orihikarna/Mozza62/MozzaBottom/Edge_Cuts-dist.png

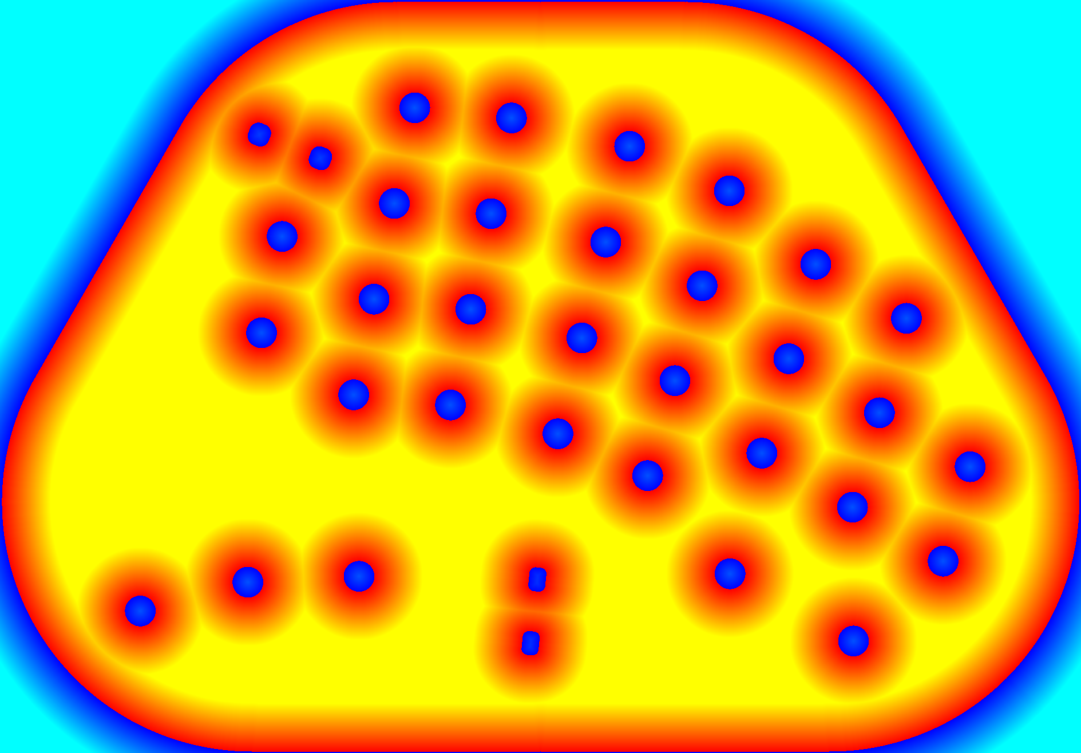
MozzaBottom/Edge_Cuts-dist.png
