orihikarna/Mozza62/layout/kbd-layout.png

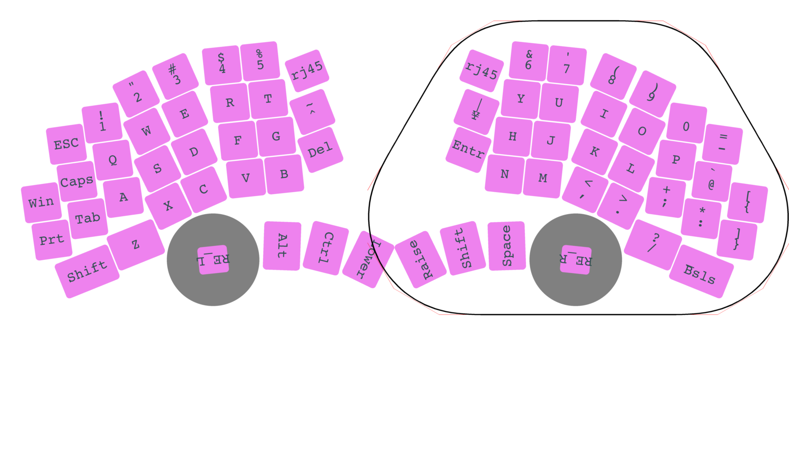
layout/kbd-layout.png
