orihikarna/Mozza62/MozzaBottom/Edge_Cuts-svg.png

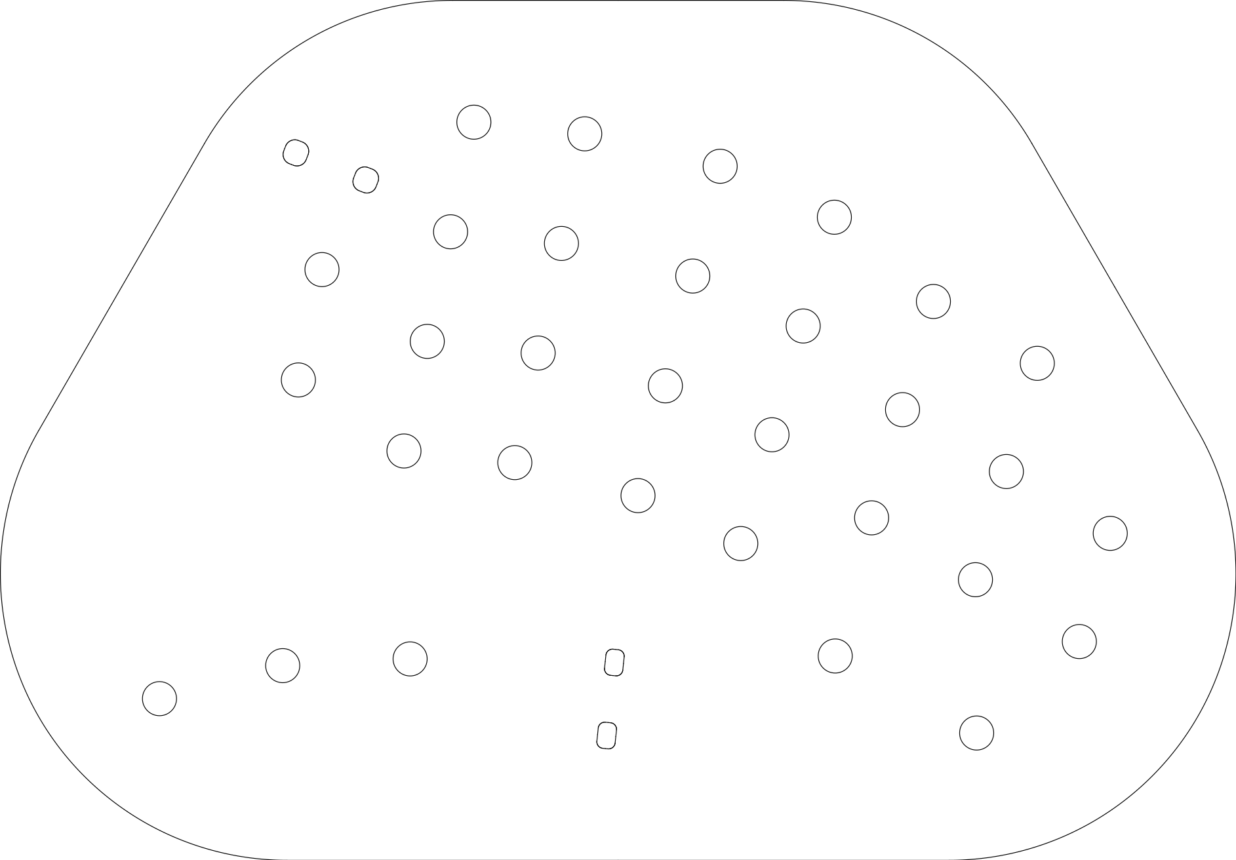
MozzaBottom/Edge_Cuts-svg.png
