orihikarna/Mozza62/layout/kbd-layout.scad

key_w = 17.0;
key_h = 17.0;
key_pos_angles = [
    [49.871, -9.102, -268.000, 22.000, 17.000, 0, "Space"],
    [-49.871, -9.102, 268.000, 22.000, 17.000, 1, "Alt"],
    [30.440, -10.126, -256.000, 22.000, 17.000, 2, "Shift"],
    [-30.440, -10.126, 256.000, 22.000, 17.000, 3, "Ctrl"],
    [11.647, -15.167, -244.000, 22.000, 17.000, 4, "Raise"],
    [-11.647, -15.167, 244.000, 22.000, 17.000, 5, "Lower"],
    [48.932, 22.620, -6.000, 17.000, 17.000, 6, "N"],
    [52.486, 39.340, -6.000, 17.000, 17.000, 7, "H"],
    [56.040, 56.060, -6.000, 17.000, 17.000, 8, "Y"],
    [59.594, 72.780, -6.000, 17.000, 17.000, 9, "&6"],
    [-48.932, 22.620, 6.000, 17.000, 17.000, 10, "B"],
    [-52.486, 39.340, 6.000, 17.000, 17.000, 11, "G"],
    [-56.040, 56.060, 6.000, 17.000, 17.000, 12, "T"],
    [-59.594, 72.780, 6.000, 17.000, 17.000, 13, "%5"],
    [65.839, 20.843, -6.000, 17.000, 17.000, 14, "M"],
    [69.393, 37.563, -6.000, 17.000, 17.000, 15, "J"],
    [72.947, 54.283, -6.000, 17.000, 17.000, 16, "U"],
    [76.501, 71.003, -6.000, 17.000, 17.000, 17, "'7"],
    [-65.839, 20.843, 6.000, 17.000, 17.000, 18, "V"],
    [-69.393, 37.563, 6.000, 17.000, 17.000, 19, "F"],
    [-72.947, 54.283, 6.000, 17.000, 17.000, 20, "R"],
    [-76.501, 71.003, 6.000, 17.000, 17.000, 21, "$4"],
    [84.626, 15.809, -24.000, 17.000, 17.000, 22, "<,"],
    [88.802, 32.558, -24.000, 17.000, 17.000, 23, "K"],
    [92.978, 49.308, -24.000, 17.000, 17.000, 24, "I"],
    [97.155, 66.057, -24.000, 17.000, 17.000, 25, "(8"],
    [-84.626, 15.809, 24.000, 17.000, 17.000, 26, "C"],
    [-88.802, 32.558, 24.000, 17.000, 17.000, 27, "D"],
    [-92.978, 49.308, 24.000, 17.000, 17.000, 28, "E"],
    [-97.155, 66.057, 24.000, 17.000, 17.000, 29, "#3"],
    [100.300, 8.500, -26.000, 17.000, 17.000, 30, ">."],
    [105.058, 25.094, -26.000, 17.000, 17.000, 31, "L"],
    [109.816, 41.687, -26.000, 17.000, 17.000, 32, "O"],
    [114.574, 58.281, -26.000, 17.000, 17.000, 33, ")9"],
    [-100.300, 8.500, 26.000, 17.000, 17.000, 34, "X"],
    [-105.058, 25.094, 26.000, 17.000, 17.000, 35, "S"],
    [-109.816, 41.687, 26.000, 17.000, 17.000, 36, "W"],
    [-114.574, 58.281, 26.000, 17.000, 17.000, 37, "\"2"],
    [120.250, 12.419, -8.000, 17.000, 17.000, 38, "+;"],
    [124.965, 28.924, -8.000, 17.000, 17.000, 39, "P"],
    [129.680, 45.428, -8.000, 17.000, 17.000, 40, " 0"],
    [-120.250, 12.419, 8.000, 17.000, 17.000, 41, "A"],
    [-124.965, 28.924, 8.000, 17.000, 17.000, 42, "Q"],
    [-129.680, 45.428, 8.000, 17.000, 17.000, 43, "!1"],
    [136.091, 2.983, -8.000, 17.000, 17.000, 44, "*:"],
    [140.806, 19.487, -8.000, 17.000, 17.000, 45, "`@"],
    [145.520, 35.992, -8.000, 17.000, 17.000, 46, "=-"],
    [-136.091, 2.983, 8.000, 17.000, 17.000, 47, "Tab"],
    [-140.806, 19.487, 8.000, 17.000, 17.000, 48, "Caps"],
    [-145.520, 35.992, 8.000, 17.000, 17.000, 49, "ESC"],
    [151.932, -6.454, -8.000, 17.000, 17.000, 50, "]}"],
    [156.647, 10.051, -8.000, 17.000, 17.000, 51, "[{"],
    [-151.932, -6.454, 8.000, 17.000, 17.000, 52, "Prt"],
    [-156.647, 10.051, 8.000, 17.000, 17.000, 53, "Win"],
    [114.702, -8.656, -22.000, 22.800, 17.000, 54, "?/"],
    [-114.702, -8.656, 22.000, 22.800, 17.000, 55, "Z"],
    [136.271, -20.407, -22.000, 26.000, 17.000, 56, "_Bsls"],
    [-136.271, -20.407, 22.000, 26.000, 17.000, 57, "Shift"],
    [32.828, 33.456, -21.234, 17.000, 17.000, 58, "Entr"],
    [36.429, 50.295, -21.234, 17.000, 17.000, 59, "|¥"],
    [-32.828, 33.456, 21.234, 17.000, 17.000, 60, "Del"],
    [-36.429, 50.295, 21.234, 17.000, 17.000, 61, "~^"],
    [38.752, 68.542, -21.234, 16.910, 15.480, 62, "rj45"],
    [-38.752, 68.542, 21.234, 16.910, 15.480, 63, "rj45"],
    [80.434, -15.221, -186.000, 13.700, 12.700, 64, "RE_R"],
    [-80.434, -15.221, 186.000, 13.700, 12.700, 65, "RE_L"],
];
