orihikarna/Mozza62/MozzaTop/MozzaTop-Edge_Cuts.pdf

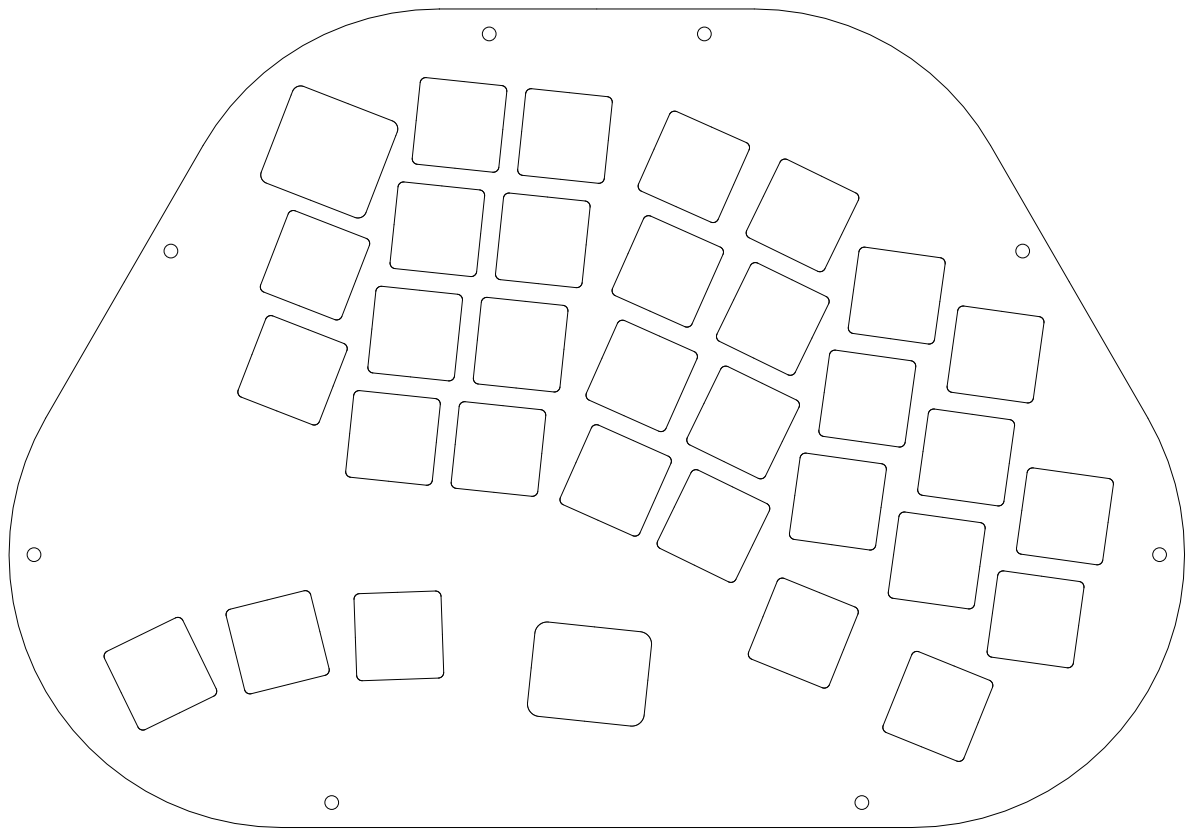
[picture p4: page 1]
