orihikarna/Mozza62/Mozzarella/Mozzarella.kicad_pcb

## KiCad design Mozzarella/Mozzarella.kicad_pcb (2024-10-05)

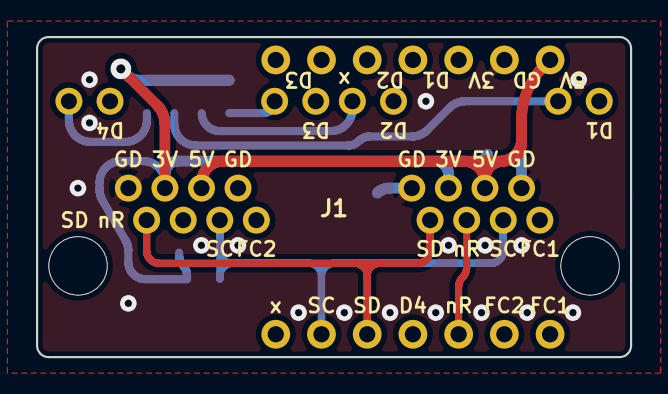
[picture p5: board Mozzarella.kicad_pcb from above]

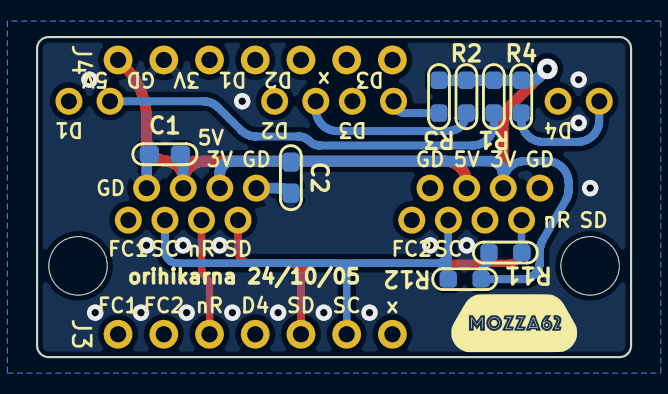
[picture p6: board Mozzarella.kicad_pcb from below]

Board: 4 copper layers, 33.0 x 17.8 mm, 12 parts (11 on the bottom side), 16 nets.

Parts:
C1, C2: 0.1u; C_1608_HandSolder
G1: LOGO; mozza62_logo2
J1: RJ45_LED_Shielded_x2; RJ45_Amphenol_RJHSE508X-02
J3, J4: Conn_01x07; PinHeader_1x07_P2.54mm_Vertical
R1, R2, R3, R4: 1k; R_1608_HandSolder
R11, R12: 2.2k; R_1608_HandSolder

Connections:
3V3: C2.1, J1.6, J1.18, J4.3, R1.1, R2.1, R3.1, R4.1, R11.2, R12.2
5VD: C1.1, J1.4, J1.16, J4.1
GND: C1.2, C2.2, J1.2, J1.8, J1.14, J1.20, J4.2
LED1: J1.9, J4.4
LED2: J1.11, J4.5
LED3: J1.21, J4.7
LED4: J1.23, J3.4
NRST: J1.5, J1.17, J3.3
unnamed: J1.10, R1.2
unnamed: J1.12, R2.2
unnamed: J1.22, R3.2
unnamed: J1.24, R4.2
RGB1: J1.1, J3.1
RGB2: J1.13, J3.2
SCK: J1.3, J1.15, J3.6, R12.1
SDA: J1.7, J1.19, J3.5, R11.1
