orihikarna/Mozza62/MozzaCircuit/MozzaCircuit.kicad_pcb

## KiCad design MozzaCircuit/MozzaCircuit.kicad_pcb (2023-05-06)

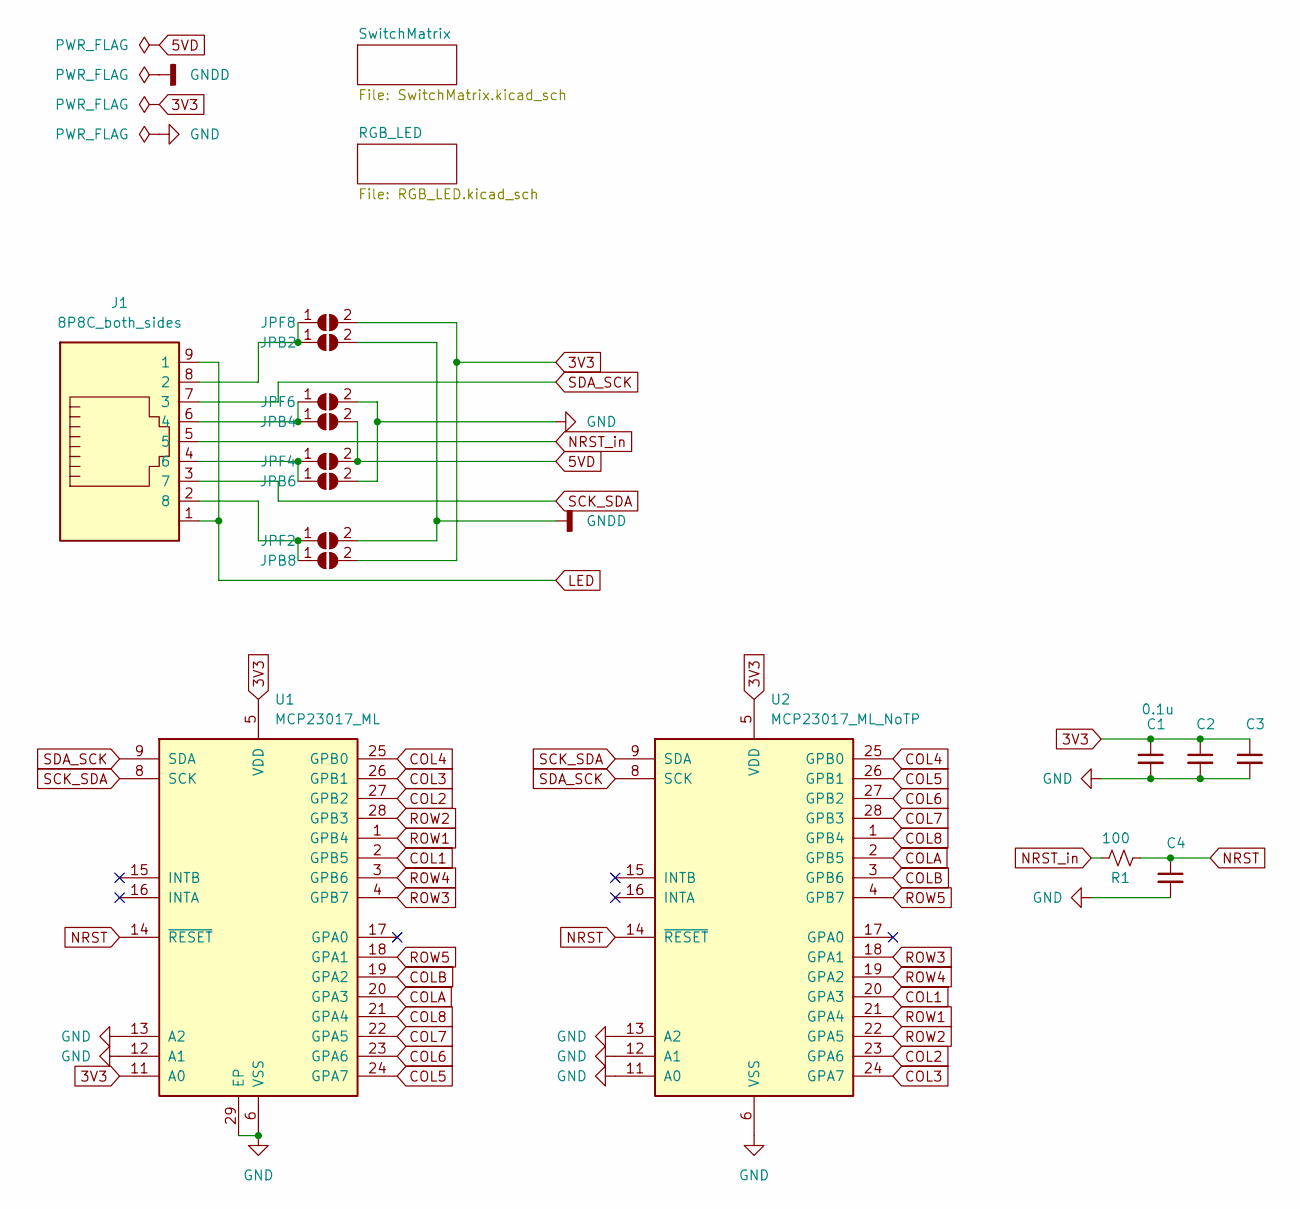
[picture p7: schematic MozzaCircuit.kicad_sch]

Parts:
C1: 0.1u; C_1608_HandSolder
C2: C_Small; C_1608_HandSolder
C3, C4: C_Small; C_1608_HandSolder_both_sides
J1: 8P8C_both_sides; RJ45_Molex_0955032884_both_sides
JPB2, JPB4, JPB6, JPB8: SolderJumper_2_Open; SolderJumper-2_P1.3mm_Open_TrianglePad1.0x1.5mm
JPF2, JPF4, JPF6, JPF8: SolderJumper_2_Open; SolderJumper-2_P1.3mm_Open_TrianglePad1.0x1.5mm
R1: 100; R_1608_HandSolder_both_sides
U1: MCP23017_ML; QFN-28-1EP_6x6mm_P0.65mm_EP4.25x4.25mm_Hand
U2: MCP23017_ML_NoTP; QFN-28-1EP_6x6mm_P0.65mm_EP4.25x4.25mm_Hand_NoTP

Connections:
3V3: C1.1, C2.1, C3.1, JPB8.2 (B), JPF8.2 (B), U1.5 (VDD), U1.11 (A0), U2.5 (VDD); also elsewhere on the board
5VD: JPB4.2 (B), JPF4.2 (B); also elsewhere on the board
COL1: U1.2 (GPB5), U2.20 (GPA3); also elsewhere on the board
COL2: U1.27 (GPB2), U2.23 (GPA6); also elsewhere on the board
COL3: U1.26 (GPB1), U2.24 (GPA7); also elsewhere on the board
COL4: U1.25 (GPB0), U2.25 (GPB0); also elsewhere on the board
COL5: U1.24 (GPA7), U2.26 (GPB1); also elsewhere on the board
COL6: U1.23 (GPA6), U2.27 (GPB2); also elsewhere on the board
COL7: U1.22 (GPA5), U2.28 (GPB3); also elsewhere on the board
COL8: U1.21 (GPA4), U2.1 (GPB4); also elsewhere on the board
COLA: U1.20 (GPA3), U2.2 (GPB5); also elsewhere on the board
COLB: U1.19 (GPA2), U2.3 (GPB6); also elsewhere on the board
GND: C1.2, C2.2, C3.2, C4.2, JPB6.2 (B), JPF6.2 (B), U1.6 (VSS), U1.12 (A1), U1.13 (A2), U1.29 (EP), U2.6 (VSS), U2.11 (A0), U2.12 (A1), U2.13 (A2); also elsewhere on the board
GNDD: JPB2.2 (B), JPF2.2 (B); also elsewhere on the board
LED: J1.1, J1.9 (1); also elsewhere on the board
NRST: C4.1, R1.2, U1.14 (~RESET), U2.14 (~RESET)
NRST_in: J1.5, R1.1
unnamed: J1.2 (8), JPB8.1 (A), JPF2.1 (A)
unnamed: J1.4 (6), JPB6.1 (A), JPF4.1 (A)
unnamed: J1.6 (4), JPB4.1 (A), JPF6.1 (A)
unnamed: J1.8 (2), JPB2.1 (A), JPF8.1 (A)
ROW1: U1.1 (GPB4), U2.21 (GPA4); also elsewhere on the board
ROW2: U1.28 (GPB3), U2.22 (GPA5); also elsewhere on the board
ROW3: U1.4 (GPB7), U2.18 (GPA1); also elsewhere on the board
ROW4: U1.3 (GPB6), U2.19 (GPA2); also elsewhere on the board
ROW5: U1.18 (GPA1), U2.4 (GPB7); also elsewhere on the board
SCK_SDA: J1.3 (7), U1.8 (SCK), U2.9 (SDA)
SDA_SCK: J1.7 (3), U1.9 (SDA), U2.8 (SCK)

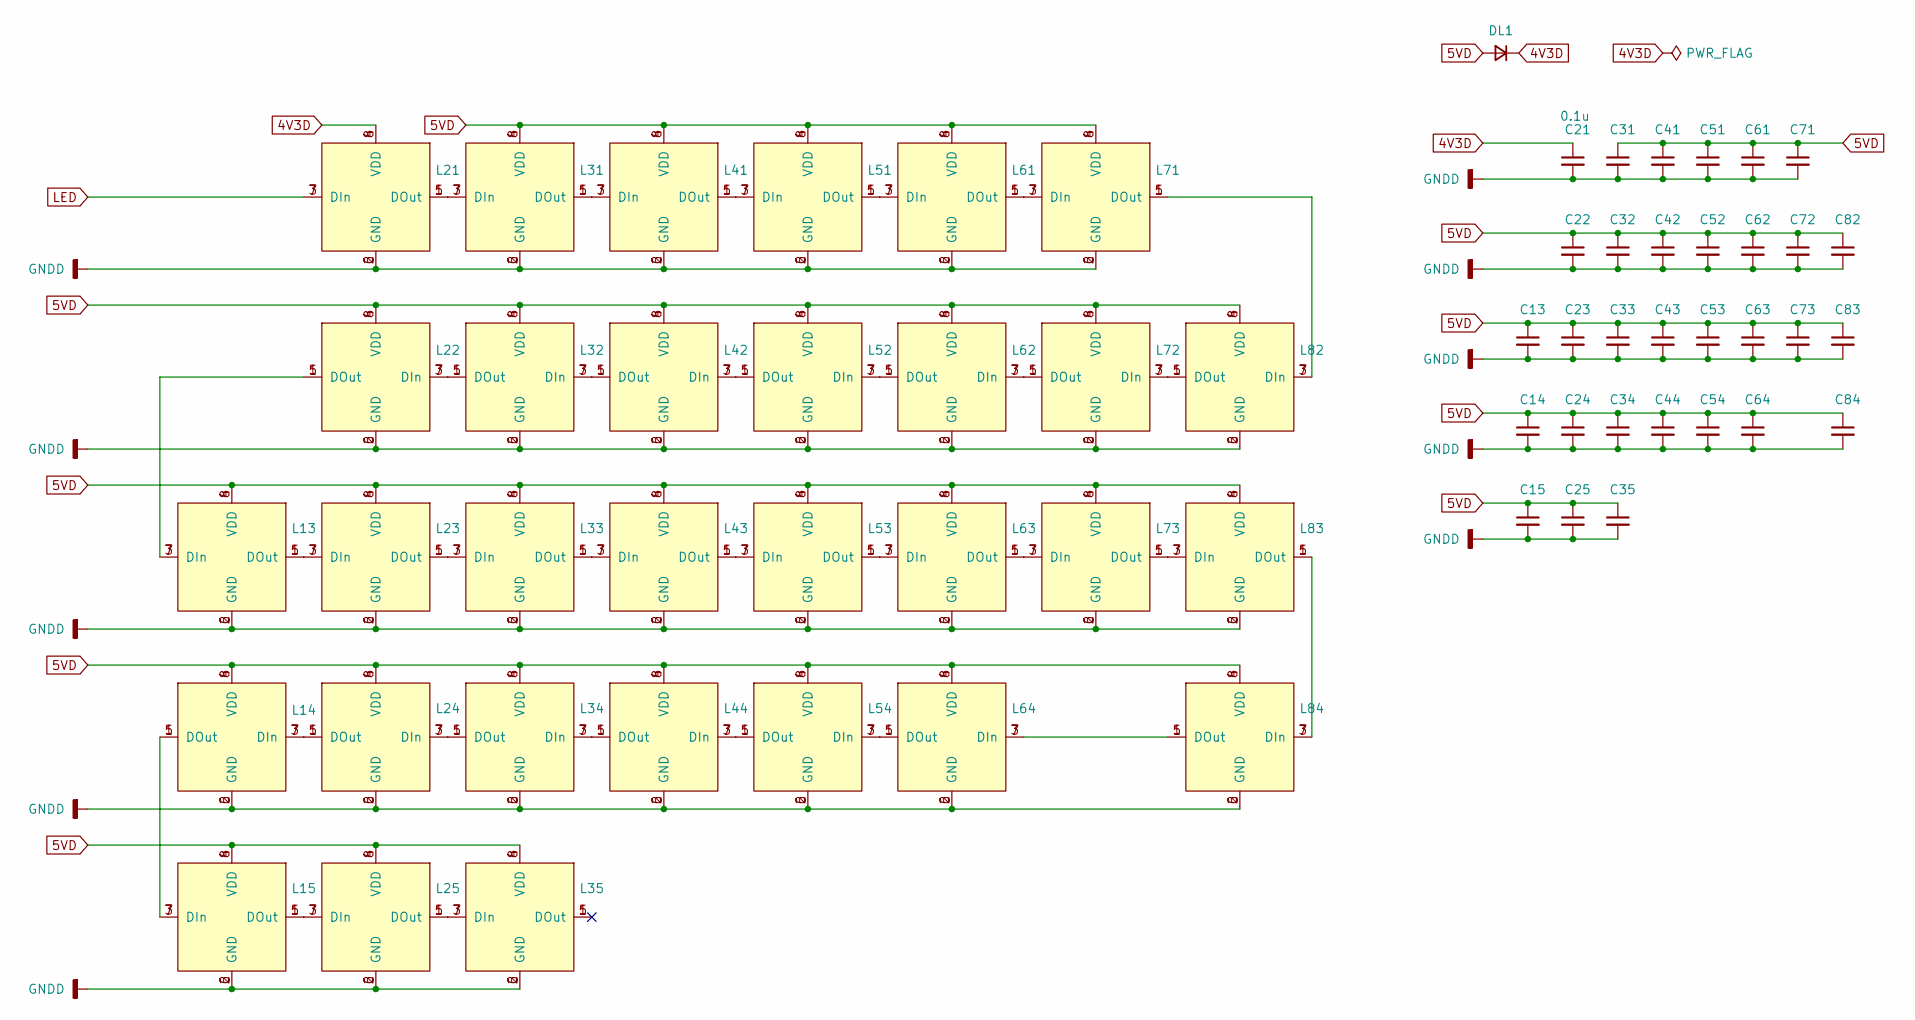
[picture p8: schematic RGB_LED.kicad_sch]

Parts:
C13, C14, C15, C22, C23, C24, C25, C31, C32, C33, C34, C35, C41, C42, C43, C44, C51, C52, C53, C54, C61, C62, C63, C64, C71, C72, C73, C82, C83, C84: C_Small; C_1608_HandSolder_both_sides
C21: 0.1u; C_1608_HandSolder_both_sides
DL1: D_Small; D_SOD-323_both_sides
L13, L14, L15, L21, L22, L23, L24, L25, L31, L32, L33, L34, L35, L41, L42, L43, L44, L51, L52, L53, L54, L61, L62, L63, L64, L71, L72, L73, L82, L83, L84: WS2812-2020_both_sides; WS2812B_2020_rev

Connections:
4V3D: C21.1, DL1.1 (K), L21.4 (VDD), L21.8; also elsewhere on the board
5VD: C13.1, C14.1, C15.1, C22.1, C23.1, C24.1, C25.1, C31.1, C32.1, C33.1, C34.1, C35.1, C41.1, C42.1, C43.1, C44.1, C51.1, C52.1, C53.1, C54.1, C61.1, C62.1, C63.1, C64.1, C71.1, C72.1, C73.1, C82.1, C83.1, C84.1, DL1.2 (A), L13.4 (VDD), L13.8, L14.4 (VDD), L14.8, L15.4 (VDD), L15.8, L22.4 (VDD), L22.8, L23.4 (VDD), L23.8, L24.4 (VDD), L24.8, L25.4 (VDD), L25.8, L31.4 (VDD), L31.8, L32.4 (VDD), L32.8, L33.4 (VDD), L33.8, L34.4 (VDD), L34.8, L35.4 (VDD), L35.8, L41.4 (VDD), L41.8, L42.4 (VDD), L42.8, L43.4 (VDD), L43.8, L44.4 (VDD), L44.8, L51.4 (VDD), L51.8, L52.4 (VDD), L52.8, L53.4 (VDD), L53.8, L54.4 (VDD), L54.8, L61.4 (VDD), L61.8, L62.4 (VDD), L62.8, L63.4 (VDD), L63.8, L64.4 (VDD), L64.8, L71.4 (VDD), L71.8, L72.4 (VDD), L72.8, L73.4 (VDD), L73.8, L82.4 (VDD), L82.8, L83.4 (VDD), L83.8, L84.4 (VDD), L84.8; also elsewhere on the board
GNDD: C13.2, C14.2, C15.2, C21.2, C22.2, C23.2, C24.2, C25.2, C31.2, C32.2, C33.2, C34.2, C35.2, C41.2, C42.2, C43.2, C44.2, C51.2, C52.2, C53.2, C54.2, C61.2, C62.2, C63.2, C64.2, C71.2, C72.2, C73.2, C82.2, C83.2, C84.2, L13.2 (GND), L13.6, L14.2 (GND), L14.6, L15.2 (GND), L15.6, L21.2 (GND), L21.6, L22.2 (GND), L22.6, L23.2 (GND), L23.6, L24.2 (GND), L24.6, L25.2 (GND), L25.6, L31.2 (GND), L31.6, L32.2 (GND), L32.6, L33.2 (GND), L33.6, L34.2 (GND), L34.6, L35.2 (GND), L35.6, L41.2 (GND), L41.6, L42.2 (GND), L42.6, L43.2 (GND), L43.6, L44.2 (GND), L44.6, L51.2 (GND), L51.6, L52.2 (GND), L52.6, L53.2 (GND), L53.6, L54.2 (GND), L54.6, L61.2 (GND), L61.6, L62.2 (GND), L62.6, L63.2 (GND), L63.6, L64.2 (GND), L64.6, L71.2 (GND), L71.6, L72.2 (GND), L72.6, L73.2 (GND), L73.6, L82.2 (GND), L82.6, L83.2 (GND), L83.6, L84.2 (GND), L84.6; also elsewhere on the board
LED: L21.3 (DIn), L21.7 (DIn); also elsewhere on the board
unnamed: L13.1 (DOut), L13.5 (DOut), L23.3 (DIn), L23.7 (DIn)
unnamed: L13.3 (DIn), L13.7 (DIn), L22.1 (DOut), L22.5 (DOut)
unnamed: L14.1 (DOut), L14.5 (DOut), L15.3 (DIn), L15.7 (DIn)
unnamed: L14.3 (DIn), L14.7 (DIn), L24.1 (DOut), L24.5 (DOut)
unnamed: L15.1 (DOut), L15.5 (DOut), L25.3 (DIn), L25.7 (DIn)
unnamed: L21.1 (DOut), L21.5 (DOut), L31.3 (DIn), L31.7 (DIn)
unnamed: L22.3 (DIn), L22.7 (DIn), L32.1 (DOut), L32.5 (DOut)
unnamed: L23.1 (DOut), L23.5 (DOut), L33.3 (DIn), L33.7 (DIn)
unnamed: L24.3 (DIn), L24.7 (DIn), L34.1 (DOut), L34.5 (DOut)
unnamed: L25.1 (DOut), L25.5 (DOut), L35.3 (DIn), L35.7 (DIn)
unnamed: L31.1 (DOut), L31.5 (DOut), L41.3 (DIn), L41.7 (DIn)
unnamed: L32.3 (DIn), L32.7 (DIn), L42.1 (DOut), L42.5 (DOut)
unnamed: L33.1 (DOut), L33.5 (DOut), L43.3 (DIn), L43.7 (DIn)
unnamed: L34.3 (DIn), L34.7 (DIn), L44.1 (DOut), L44.5 (DOut)
unnamed: L41.1 (DOut), L41.5 (DOut), L51.3 (DIn), L51.7 (DIn)
unnamed: L42.3 (DIn), L42.7 (DIn), L52.1 (DOut), L52.5 (DOut)
unnamed: L43.1 (DOut), L43.5 (DOut), L53.3 (DIn), L53.7 (DIn)
unnamed: L44.3 (DIn), L44.7 (DIn), L54.1 (DOut), L54.5 (DOut)
unnamed: L51.1 (DOut), L51.5 (DOut), L61.3 (DIn), L61.7 (DIn)
unnamed: L52.3 (DIn), L52.7 (DIn), L62.1 (DOut), L62.5 (DOut)
unnamed: L53.1 (DOut), L53.5 (DOut), L63.3 (DIn), L63.7 (DIn)
unnamed: L54.3 (DIn), L54.7 (DIn), L64.1 (DOut), L64.5 (DOut)
unnamed: L61.1 (DOut), L61.5 (DOut), L71.3 (DIn), L71.7 (DIn)
unnamed: L62.3 (DIn), L62.7 (DIn), L72.1 (DOut), L72.5 (DOut)
unnamed: L63.1 (DOut), L63.5 (DOut), L73.3 (DIn), L73.7 (DIn)
unnamed: L64.3 (DIn), L64.7 (DIn), L84.1 (DOut), L84.5 (DOut)
unnamed: L71.1 (DOut), L71.5 (DOut), L82.3 (DIn), L82.7 (DIn)
unnamed: L72.3 (DIn), L72.7 (DIn), L82.1 (DOut), L82.5 (DOut)
unnamed: L73.1 (DOut), L73.5 (DOut), L83.3 (DIn), L83.7 (DIn)
unnamed: L83.1 (DOut), L83.5 (DOut), L84.3 (DIn), L84.7 (DIn)

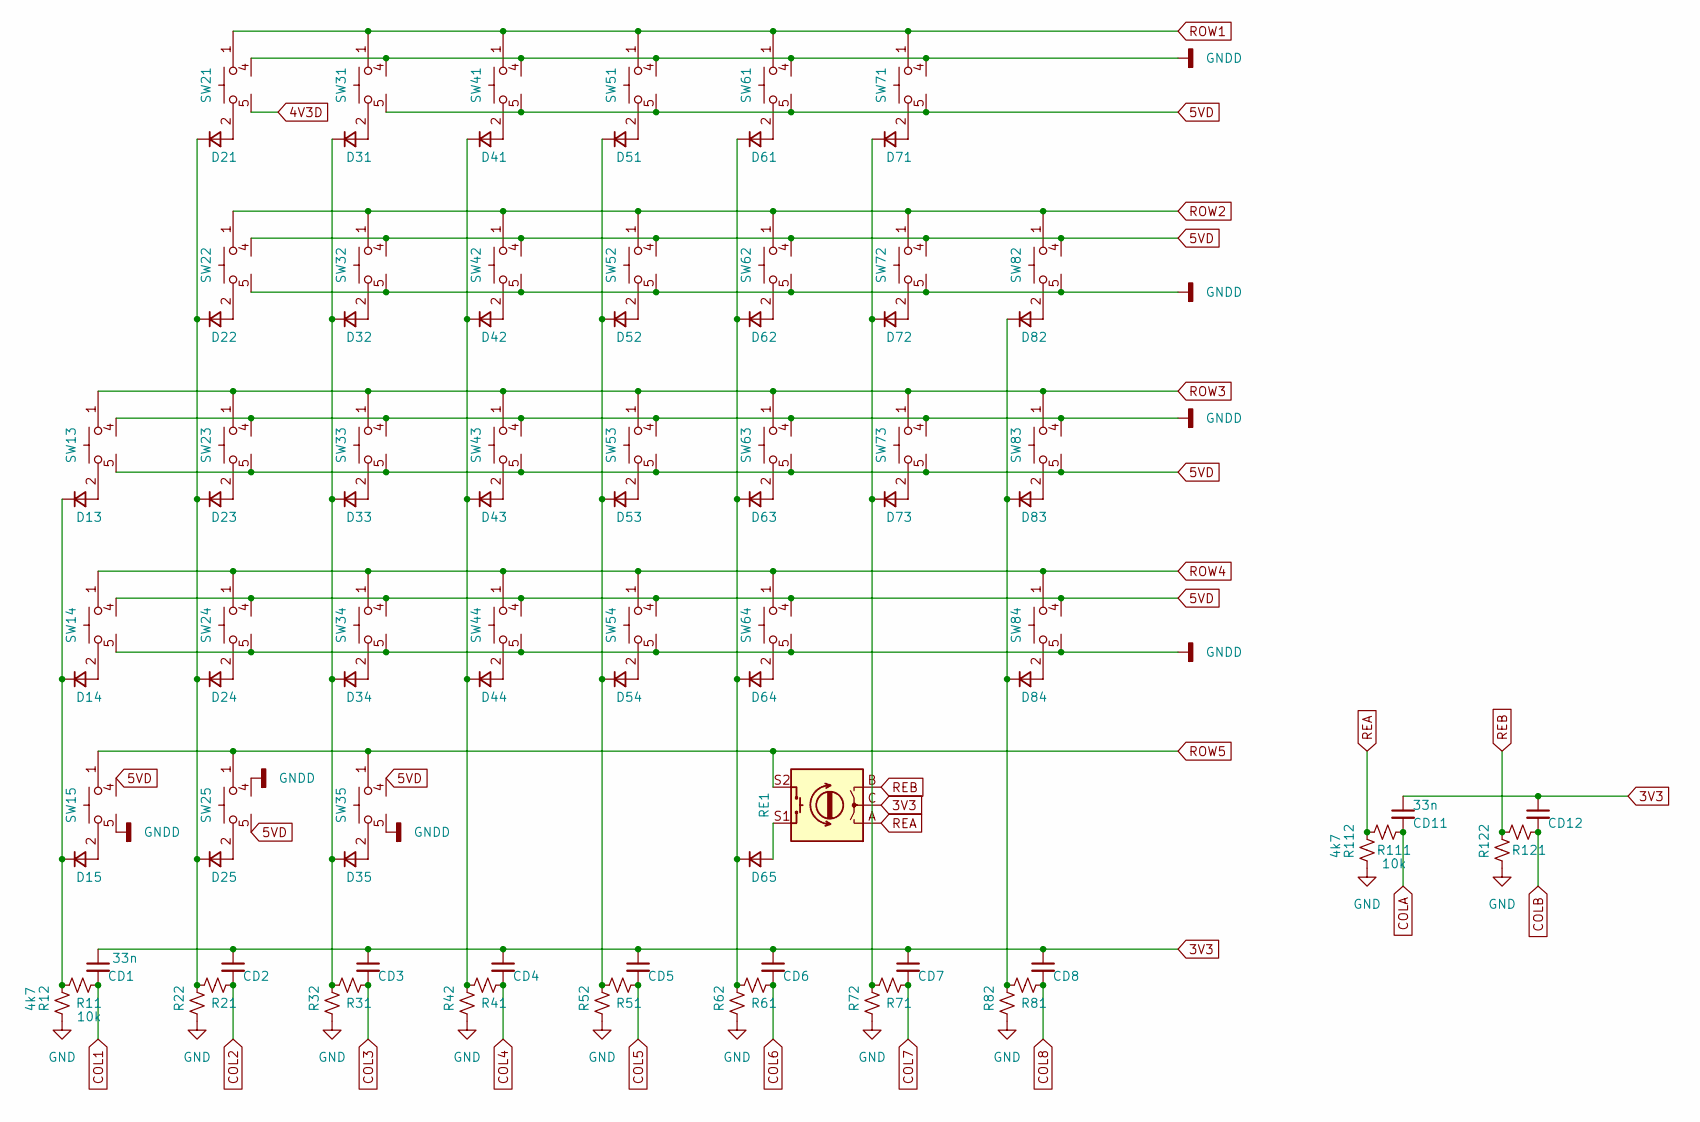
[picture p9: schematic SwitchMatrix.kicad_sch]

Parts:
CD1, CD11: 33n; C_1608_HandSolder_both_sides
CD2, CD3, CD4, CD5, CD6, CD7, CD8, CD12: C_Small; C_1608_HandSolder_both_sides
D13, D14, D15, D21, D22, D23, D24, D25, D31, D32, D33, D34, D35, D41, D42, D43, D44, D51, D52, D53, D54, D61, D62, D63, D64, D65, D71, D72, D73, D82, D83, D84: D_Small; D_SOD-323_both_sides
R11, R111: 10k; R_1608_HandSolder_both_sides
R12, R112: 4k7; R_1608_HandSolder_both_sides
R21, R22, R31, R32, R41, R42, R51, R52, R61, R62, R71, R72, R81, R82, R121, R122: R_Small_US; R_1608_HandSolder_both_sides
RE1: RotaryEncoder_Switch; RotaryEncoder_Bourns_PEC12R-4215F
SW13, SW14, SW15, SW21, SW22, SW23, SW24, SW25, SW31, SW32, SW33, SW34, SW35, SW41, SW42, SW43, SW44, SW51, SW52, SW53, SW54, SW61, SW62, SW63, SW64, SW71, SW72, SW73, SW82, SW83, SW84: SW_ChocV2_rev; ChocV2_rev

Connections:
3V3: CD1.1, CD2.1, CD3.1, CD4.1, CD5.1, CD6.1, CD7.1, CD8.1, CD11.1, CD12.1, RE1.C; also elsewhere on the board
4V3D: SW21.5; also elsewhere on the board
5VD: SW13.5, SW14.4, SW15.4, SW22.4, SW23.5, SW24.4, SW25.5, SW31.5, SW32.4, SW33.5, SW34.4, SW35.4, SW41.5, SW42.4, SW43.5, SW44.4, SW51.5, SW52.4, SW53.5, SW54.4, SW61.5, SW62.4, SW63.5, SW64.4, SW71.5, SW72.4, SW73.5, SW82.4, SW83.5, SW84.4; also elsewhere on the board
COL1: CD1.2, R11.2; also elsewhere on the board
COL2: CD2.2, R21.2; also elsewhere on the board
COL3: CD3.2, R31.2; also elsewhere on the board
COL4: CD4.2, R41.2; also elsewhere on the board
COL5: CD5.2, R51.2; also elsewhere on the board
COL6: CD6.2, R61.2; also elsewhere on the board
COL7: CD7.2, R71.2; also elsewhere on the board
COL8: CD8.2, R81.2; also elsewhere on the board
COLA: CD11.2, R111.2; also elsewhere on the board
COLB: CD12.2, R121.2; also elsewhere on the board
GND: R12.2, R22.2, R32.2, R42.2, R52.2, R62.2, R72.2, R82.2, R112.2, R122.2; also elsewhere on the board
GNDD: SW13.4, SW14.5, SW15.5, SW21.4, SW22.5, SW23.4, SW24.5, SW25.4, SW31.4, SW32.5, SW33.4, SW34.5, SW35.5, SW41.4, SW42.5, SW43.4, SW44.5, SW51.4, SW52.5, SW53.4, SW54.5, SW61.4, SW62.5, SW63.4, SW64.5, SW71.4, SW72.5, SW73.4, SW82.5, SW83.4, SW84.5; also elsewhere on the board
unnamed: D13.1 (K), D14.1 (K), D15.1 (K), R11.1, R12.1
unnamed: D13.2 (A), SW13.2, SW13.3
unnamed: D14.2 (A), SW14.2, SW14.3
unnamed: D15.2 (A), SW15.2, SW15.3
unnamed: D21.1 (K), D22.1 (K), D23.1 (K), D24.1 (K), D25.1 (K), R21.1, R22.1
unnamed: D21.2 (A), SW21.2, SW21.3
unnamed: D22.2 (A), SW22.2, SW22.3
unnamed: D23.2 (A), SW23.2, SW23.3
unnamed: D24.2 (A), SW24.2, SW24.3
unnamed: D25.2 (A), SW25.2, SW25.3
unnamed: D31.1 (K), D32.1 (K), D33.1 (K), D34.1 (K), D35.1 (K), R31.1, R32.1
unnamed: D31.2 (A), SW31.2, SW31.3
unnamed: D32.2 (A), SW32.2, SW32.3
unnamed: D33.2 (A), SW33.2, SW33.3
unnamed: D34.2 (A), SW34.2, SW34.3
unnamed: D35.2 (A), SW35.2, SW35.3
unnamed: D41.1 (K), D42.1 (K), D43.1 (K), D44.1 (K), R41.1, R42.1
unnamed: D41.2 (A), SW41.2, SW41.3
unnamed: D42.2 (A), SW42.2, SW42.3
unnamed: D43.2 (A), SW43.2, SW43.3
unnamed: D44.2 (A), SW44.2, SW44.3
unnamed: D51.1 (K), D52.1 (K), D53.1 (K), D54.1 (K), R51.1, R52.1
unnamed: D51.2 (A), SW51.2, SW51.3
unnamed: D52.2 (A), SW52.2, SW52.3
unnamed: D53.2 (A), SW53.2, SW53.3
unnamed: D54.2 (A), SW54.2, SW54.3
unnamed: D61.1 (K), D62.1 (K), D63.1 (K), D64.1 (K), D65.1 (K), R61.1, R62.1
unnamed: D61.2 (A), SW61.2, SW61.3
unnamed: D62.2 (A), SW62.2, SW62.3
unnamed: D63.2 (A), SW63.2, SW63.3
unnamed: D64.2 (A), SW64.2, SW64.3
unnamed: D65.2 (A), RE1.S1
unnamed: D71.1 (K), D72.1 (K), D73.1 (K), R71.1, R72.1
unnamed: D71.2 (A), SW71.2, SW71.3
unnamed: D72.2 (A), SW72.2, SW72.3
unnamed: D73.2 (A), SW73.2, SW73.3
unnamed: D82.1 (K), D83.1 (K), D84.1 (K), R81.1, R82.1
unnamed: D82.2 (A), SW82.2, SW82.3
unnamed: D83.2 (A), SW83.2, SW83.3
unnamed: D84.2 (A), SW84.2, SW84.3
REA: R111.1, R112.1, RE1.A
REB: R121.1, R122.1, RE1.B
ROW1: SW21.1, SW31.1, SW41.1, SW51.1, SW61.1, SW71.1; also elsewhere on the board
ROW2: SW22.1, SW32.1, SW42.1, SW52.1, SW62.1, SW72.1, SW82.1; also elsewhere on the board
ROW3: SW13.1, SW23.1, SW33.1, SW43.1, SW53.1, SW63.1, SW73.1, SW83.1; also elsewhere on the board
ROW4: SW14.1, SW24.1, SW34.1, SW44.1, SW54.1, SW64.1, SW84.1; also elsewhere on the board
ROW5: RE1.S2, SW15.1, SW25.1, SW35.1; also elsewhere on the board

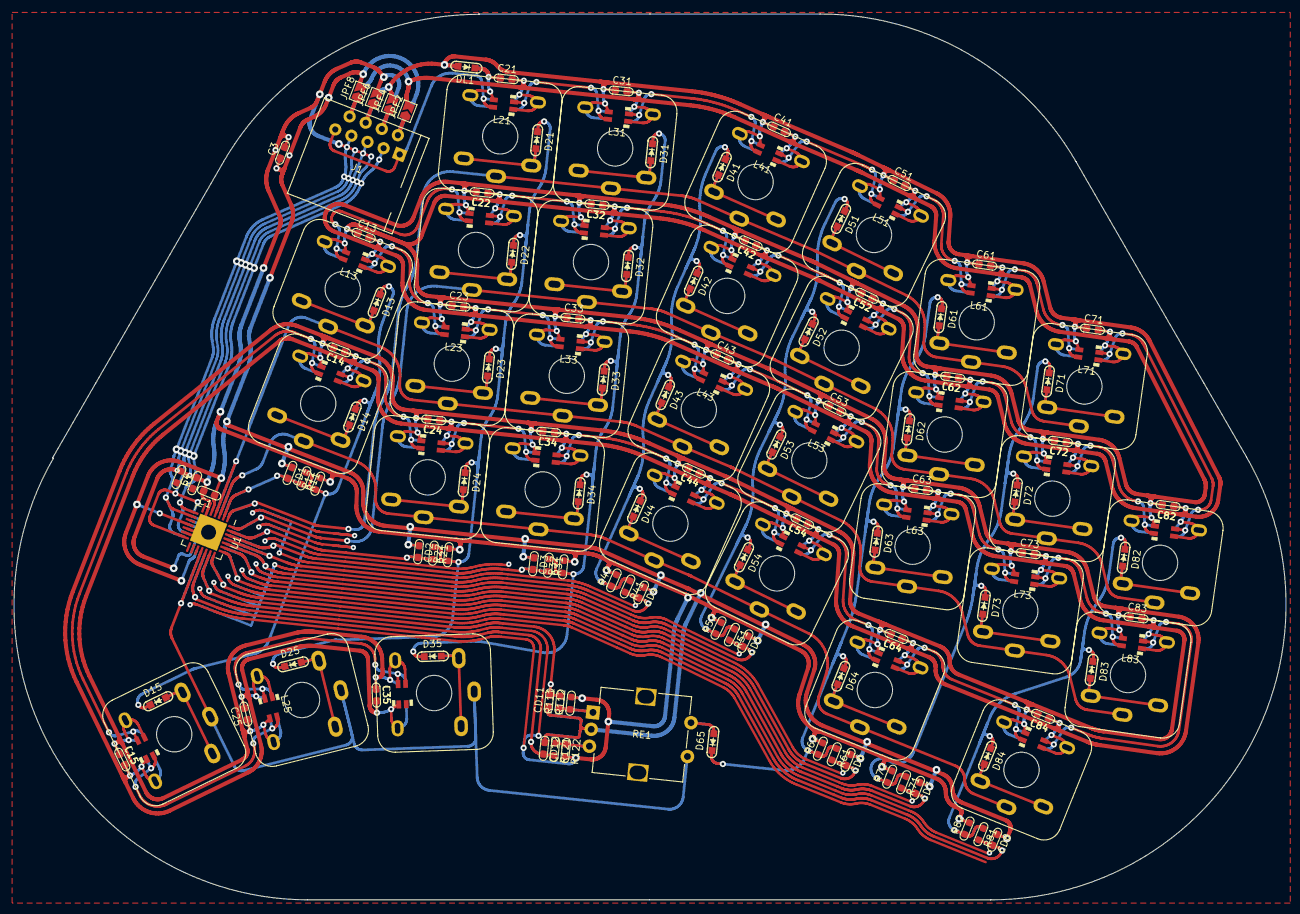
[picture p10: board MozzaCircuit.kicad_pcb from above]

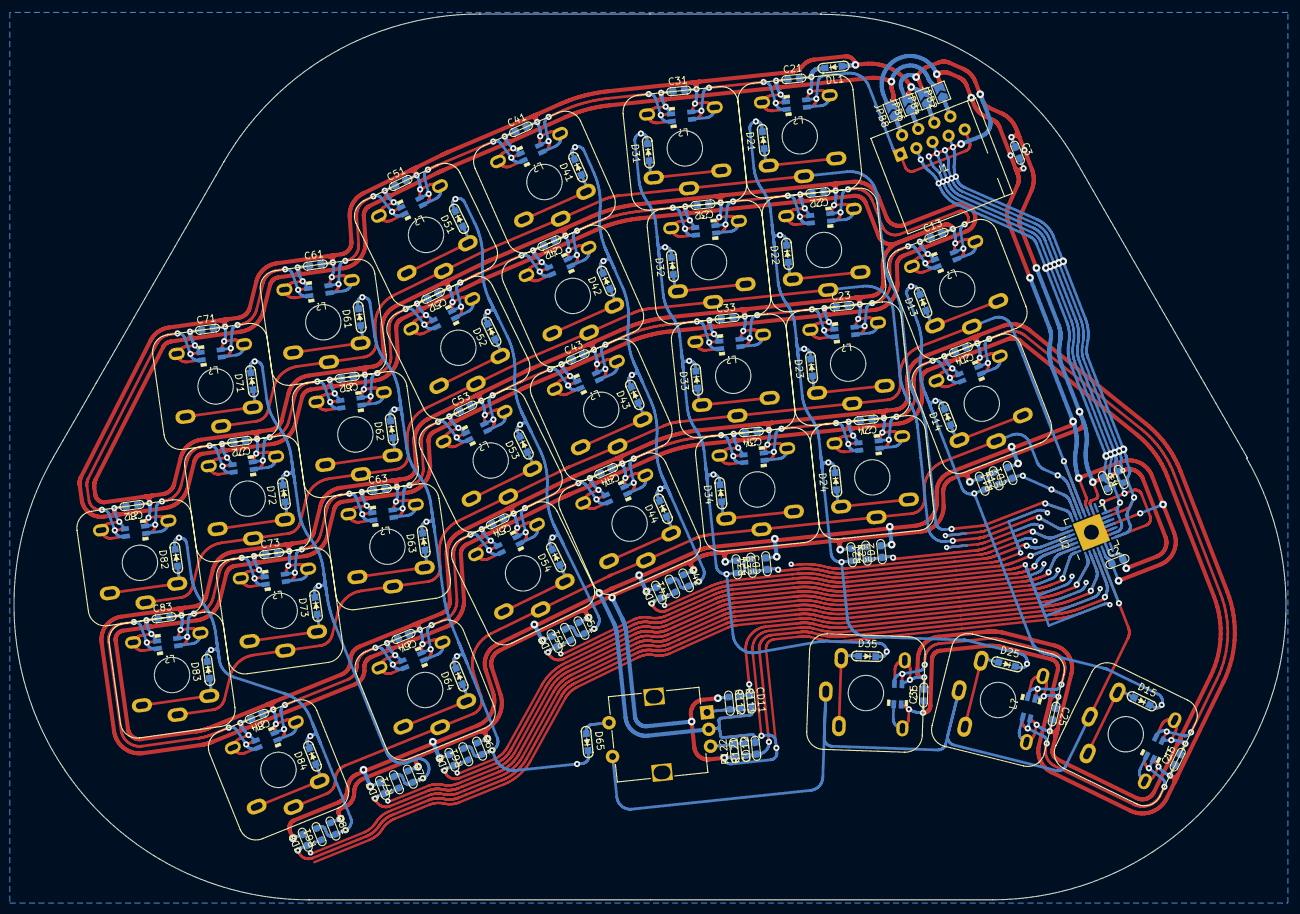
[picture p11: board MozzaCircuit.kicad_pcb from below]

Board: 2 copper layers, 187.1 x 130.3 mm, 173 parts (7 on the bottom side), 101 nets.
