orihikarna/Mozza62/Firmcheese/src/log.h

#pragma once

#include <Arduino.h>

#define LOG_GLOBAL_ENABLE

#define LL_DUMP 0
#define LL_DEBUG 1
#define LL_INFO 2
#define LL_WARN 3
#define LL_ERROR 4
#define LL_CRITICAL 5
#define LL_NONE 6

// default log level
#ifndef LOG_LEVEL
// #define LOG_LEVEL LL_DEBUG
#define LOG_LEVEL LL_INFO
// #define LOG_LEVEL LL_WARN
// #define LOG_LEVEL LL_ERROR
// #define LOG_LEVEL LL_NONE
#endif

#define _LOG_PRINTF(fmt, level, ...) \
  Serial.printf("[%s][%s:%s(%d)] " fmt "\n", level, __FILE__, __FUNCTION__, __LINE__, ##__VA_ARGS__)

#if defined(LOG_GLOBAL_ENABLE) && LOG_LEVEL <= LL_DUMP
#define LOG_DUMP(fmt, ...) _LOG_PRINTF(fmt, "DUMP", ##__VA_ARGS__)
#else
#define LOG_DUMP(fmt, ...)
#endif

#if defined(LOG_GLOBAL_ENABLE) && LOG_LEVEL <= LL_DEBUG
#define LOG_DEBUG(fmt, ...) _LOG_PRINTF(fmt, "DEBUG", ##__VA_ARGS__)
#else
#define LOG_DEBUG(fmt, ...)
#endif

#if defined(LOG_GLOBAL_ENABLE) && LOG_LEVEL <= LL_INFO
#define LOG_INFO(fmt, ...) _LOG_PRINTF(fmt, "INFO", ##__VA_ARGS__)
#else
#define LOG_INFO(fmt, ...)
#endif

#if defined(LOG_GLOBAL_ENABLE) && LOG_LEVEL <= LL_WARN
#define LOG_WARN(fmt, ...) _LOG_PRINTF(fmt, "WARN", ##__VA_ARGS__)
#else
#define LOG_WARN(fmt, ...)
#endif

#if defined(LOG_GLOBAL_ENABLE) && LOG_LEVEL <= LL_ERROR
#define LOG_ERROR(fmt, ...) _LOG_PRINTF(fmt, "ERROR", ##__VA_ARGS__)
#else
#define LOG_ERROR(fmt, ...)
#endif
