orihikarna/Mozza62/Firmcheese/src/keyevent.hpp

#pragma once

#include "ringbuf.hpp"
// #include "util.hpp"

enum class EKeyEvent {
  None = 0x00,
  Released = 0x01,
  Pressed = 0x02,
};

using keycode_t = uint16_t;

struct KeyEvent {
  KeyEvent(keycode_t _code, EKeyEvent _event, int16_t _tick_ms = 0)
      : code(_code), event(_event), tick_ms(_tick_ms) {}
  keycode_t code = 0;
  EKeyEvent event = EKeyEvent::None;
  int16_t tick_ms = 0;

  inline bool isPressed() const { return event == EKeyEvent::Pressed; }
};

using KeyEventBuffer = RingBuffer<KeyEvent>;
