orihikarna/Mozza62/Firmcheese/src/key_scanner.h

#pragma once

#include <Adafruit_MCP23X17.h>

#include <array>
#include <cstdint>

#include "key_event.h"
#include "key_switch.h"

enum ESide {
  Left = 0,
  Right = 1,
};

enum ESwitchState : uint8_t {
  IsON = 0x01,
  // 0x02-0x40 = old IsOn
  IsPressed = 0x80,
};

class KeyScanner {
 private:
  std::array<Adafruit_MCP23X17, kNumSides> mcp_;
  std::array<bool, kNumSides> mcp_inited_;
  std::array<uint32_t, kNumSides> mcp_disconnected_ms_;

  void mcp_init();
  uint16_t mcp_get_col(uint8_t side);
  void mcp_set_row(uint8_t row);

 private:
  const uint8_t mcp_enabled_mask_ = 0x03;
  uint8_t scan_row_ = 0;
  std::array<uint8_t, EKeySW::NumSWs> key_state_;
  std::array<uint8_t, kNumSides> rot_state_;

 public:
  void init();
  void scan(KeyEventBuffer *evbuf);
  inline bool is_pressed(uint8_t swidx) const { return key_state_[swidx] & static_cast<int>(ESwitchState::IsPressed); }
  inline uint8_t *getSwitchStateData() { return key_state_.data(); }

 private:
  void update_key_state(KeyEventBuffer *fifo, uint8_t key, uint8_t val);
};
