orihikarna/Mozza62/(commit log)

2022-08-19 added pythonand scad scripts for encode knob
    [bumpy.scad]
2022-08-19 adjust size, avoid elephant foot
    [bumpy.scad]
2022-08-20 4-th degree curve, axis bottom radius = 7mm, revert bump size
    [bumpy.scad]
2022-08-20 reduce wall thickness, star walls
    [bumpy.scad]
2022-08-24 2nd print
    [demo-plate.scad, kbd-layout.scad]
2022-08-25 3rd print
    [kbd-layout.scad]
2022-08-26 4th print
    [demo-plate.scad, kbd-layout.scad]
2022-08-27 5th print
    [demo-plate.scad, kbd-layout.scad]
2022-08-28 6th print
    [kbd-layout.scad]
2022-08-30 7th print
    [bumpy.scad, demo-plate.scad, kbd-layout.scad]
2022-11-26 no10 (edgecuts)
    [kbd-layout.scad]
2022-12-11 hexagonal edge cuts
    [demo-plate.scad, kbd-layout.scad]
2022-12-12 round shape
    [kbd-layout.scad]
2022-12-17 more round corner (15deg)
    [demo-plate.scad, kbd-layout.scad]
2022-12-21 added footprints
2022-12-25 sw schema
    [MozzaCircuit.kicad_pcb, MozzaCircuit.kicad_sch, kbd-layout.scad]
2022-12-25 switch matrix
    [IO_expander.kicad_sch, MozzaCircuit.kicad_sch, RGB_LED.kicad_sch]
2022-12-25 added rotary encoder
    [IO_expander.kicad_sch, MozzaCircuit.kicad_sch]
2022-12-28 led matrix
    [IO_expander.kicad_sch, MozzaCircuit.kicad_sch, RGB_LED.kicad_sch, SwitchMatrix.kicad_sch]
2022-12-28 removed unused sch
    [IO_expander.kicad_sch]
2022-12-28 added 3D models, debounce for encoder
    [MozzaCircuit.kicad_sch, RGB_LED.kicad_sch, SwitchMatrix.kicad_sch]
2022-12-29 added qfn footprints
    [MozzaCircuit.kicad_sch, SwitchMatrix.kicad_sch]
2022-12-29 init pcb
    [MozzaCircuit.kicad_pcb, MozzaCircuit.kicad_sch]
2022-12-31 choc separate pins, qfn no tp, led oval hole
2022-12-31 kicad output
2022-12-31 started place and route
    [MozzaCircuit.kicad_sch, RGB_LED.kicad_sch, SwitchMatrix.kicad_sch]
2022-12-31 placed sw and led
    [MozzaCircuit.kicad_pcb]
2022-12-31 led direction
    [MozzaCircuit.kicad_pcb, MozzaCircuit.kicad_sch, RGB_LED.kicad_sch, SwitchMatrix.kicad_sch]
2023-01-01 1608 R&C
    [MozzaCircuit.kicad_sch, RGB_LED.kicad_sch, SwitchMatrix.kicad_sch]
2023-01-01 led power
2023-01-03 led wiring
    [MozzaCircuit.kicad_pcb]
2023-01-04 arc corner wiring
2023-01-04 led dat wiring
2023-01-05 led wiring, fix fp silk overlaps
    [SwitchMatrix.kicad_sch]
2023-01-05 fixed diode fp courtyard
2023-01-06 footprint circles, fix switch sch
    [RGB_LED.kicad_sch, SwitchMatrix.kicad_sch]
2023-01-07 led pwr wiring
2023-01-12 horizontal wiring
2023-01-12 led horz wiring
2023-01-12 led diode wiring
2023-01-12 fix R footprint
2023-01-14 connecting diode cols
2023-01-15 column diodes
    [MozzaCircuit.kicad_sch, SwitchMatrix.kicad_sch]
2023-01-19 wiring debounce
2023-01-19 wiring debouse
2023-01-26 debounce row wiring
2023-01-27 debounce gnd
2023-01-27 led right ends wiring
    [MozzaCircuit.kicad_sch, RGB_LED.kicad_sch, SwitchMatrix.kicad_sch]
2023-01-28 thumb led wiring
    [RGB_LED.kicad_sch]
2023-01-28 led left end
2023-01-29 rotend debounce
    [MozzaCircuit.kicad_sch, SwitchMatrix.kicad_sch]
2023-01-30 placing led vias for wiring
2023-01-31 led wire vias
2023-02-01 thumb diodes
2023-02-02 adding horz para lines
2023-02-03 rotate rot_enc
    [MozzaCircuit.kicad_sch, RGB_LED.kicad_sch, SwitchMatrix.kicad_sch]
2023-02-06 expander vias
    [MozzaCircuit.kicad_sch]
2023-02-08 drawing exp horz lines
    [MozzaCircuit.kicad_sch]
2023-02-09 exp wires
2023-02-11 exp wire param adjust
2023-02-12 led pwr line, row vert lines
    [MozzaCircuit.kicad_sch]
2023-02-14 wiring rj45
    [MozzaCircuit.kicad_sch]
2023-02-19 rj45 wiring
    [MozzaCircuit.kicad_sch]
2023-02-22 rj45 circular wiring
2023-03-05 rj45 - exp wiring
2023-03-11 led power, rotenc power
2023-03-18 modified i2c addr
    [MozzaCircuit.kicad_sch]
2023-03-19 removed unneeded led vias
2023-03-19 led vias
2023-03-19 cleaning row led lines
2023-03-21 increased power via size
2023-03-21 rj45 --> led
2023-03-22 led right ends
2023-03-25 led thumbing
2023-03-25 led reduced a via, thumbs
2023-03-25 led thumbs done
2023-03-26 led thumb lines
2023-03-26 dbnc position & wiring adjustment
2023-03-26 rotenc diode
    [RGB_LED.kicad_sch, SwitchMatrix.kicad_sch]
2023-04-08 rj45 to exp wire
2023-04-16 led lines
    [MozzaCircuit.kicad_sch, RGB_LED.kicad_sch, SwitchMatrix.kicad_sch]
2023-04-16 localize led vias
2023-04-19 led line ctr
2023-04-19 led func
2023-04-22 col horz gnd vias
2023-04-29 exp wire
2023-04-29 exp gnd vias
2023-05-02 exp flower
2023-05-03 exp gnd lines
2023-05-05 adjust board size and rj45 pos
2023-05-05 adjusted board size and rj45 pos
2023-05-05 exp vias & wires
2023-05-06 added power cap
    [MozzaCircuit.kicad_pcb, MozzaCircuit.kicad_sch]
2023-05-07 added gnd via to avoid warning
2023-05-07 gnd vias
2023-05-07 key gnd vias
2023-05-08 swap gnd and 3v3 of rj45
    [MozzaCircuit.kicad_sch]
2023-05-11 added gnd via for col1
2023-05-11 added gnd via for rj45
2023-05-11 adjusted gnd vias
2023-05-11 fixed gnd trace
2023-05-13 added sw gnd vias
2023-05-14 changed row lines to have better ground fill
    [SwitchMatrix.kicad_sch]
2023-05-14 fixed drc errors
    [SwitchMatrix.kicad_sch]
2023-05-15 added gnd vias
2023-05-16 col horz lines & led 4-thumb adjust
2023-05-20 adjust gnd vias
2023-05-21 edgecuts, gnd vias, screw holes
    [MozzaCircuit.kicad_sch]
2023-05-27 enlarged holes of rj45 & rotenc
2023-06-01 added logo, part holes
2023-06-03 added Bottom plate, mod_props.json
    [MozzaBottom.kicad_pcb, MozzaBottom.kicad_sch]
2023-06-10 trying rule areas
    [MozzaBottom.kicad_sch]
2023-06-11 back side
    [MozzaBottom.kicad_sch]
2023-06-11 board names
2023-06-11 added middle, spacer, top boards
    [MozzaMiddle.kicad_sch, MozzaSpacer.kicad_sch, MozzaTop.kicad_sch]
2023-06-11 added logo
    [MozzaMiddle.kicad_pcb, MozzaSpacer.kicad_pcb]
2023-06-11 added board name
2023-06-12 spacer holes
2023-06-17 big hole for spacer plate
2023-06-18 cap/resister values
    [MozzaCircuit.kicad_sch, RGB_LED.kicad_sch, SwitchMatrix.kicad_sch]
2023-06-18 top plate
    [MozzaTop.kicad_pcb]
2023-06-18 fixed rj45 foot print
    [MozzaTop.kicad_pcb]
2023-06-18 export dxf
    [MozzaTop-Edge_Cuts.dxf]
2023-06-18 plot SVG, convert it to DXF
    [MozzaTop-Edge_Cuts.dxf]
2023-06-18 top plate pdf
    [MozzaTop-Edge_Cuts.dxf, MozzaTop.kicad_pcb]
2023-06-18 generated gerber files
2023-06-24 added mozzarella board
    [Mozzarella.kicad_sch]
2023-06-27 cleaned rj45 foot print
    [Mozzarella.kicad_sch]
2023-07-04 scad output
    [kbd-layout.scad]
2023-07-24 initial led & mcp check
2023-07-29 M5Atom-Matrix full led, switch
2023-08-12 add i2c
2023-08-13 i2c keyscan check
2023-08-19 changed to m5atom board
2023-10-29 update key sw layout, not working
    [key_scanner.cpp, main.cpp]
2023-11-03 impl rot switches
2024-08-29 adding led feature
2024-08-30 fix led number
2024-08-30 measure led time
2024-08-30 overlay led
2024-08-31 adjust led effects
2024-09-03 replaced BLE library to fix conection problem
    [main.cpp, proc_nkro.hpp]
2024-09-06 lower log level, fix led period
    [key_scanner.cpp, log.h, main.cpp, proc_layer.hpp, proc_led.cpp, proc_nkro.hpp]
2024-09-07 add keybstatus for led
2024-09-14 cable disconnect
2024-09-14 adjusted status led color
2024-09-16 ble name, board led (wip)
2024-09-19 start wiring rella
    [Mozzarella.kicad_sch]
2024-09-22 led on green
2024-09-22 hide xial mod
    [Mozzarella.kicad_sch]
2024-09-23 changing led r side
2024-09-23 fixed r wires
2024-09-23 fixed board height
2024-09-26 add caps
    [Mozzarella.kicad_sch]
2024-09-28 i2c regs wip
    [Mozzarella.kicad_sch]
2024-09-28 rgb1 wire
2024-10-05 final check
    [Mozzarella.kicad_pcb]
2024-10-05 generated gerber
    [Mozzarella.kicad_pcb]
2024-10-29 add esp32 env
2024-10-31 add esp32 proj
2024-11-01 fix board name
2024-11-01 fixed led
2024-11-02 fix led blinks
2024-12-30 update [Tab] key position, update for Python updates
    [kbd-layout.scad]
2025-09-24 disavle LED
2025-09-26 insert unmod before emacs
2025-09-27 add ESP32C6 conf
